kochka/pix_frame/hardware/mechanical/left_side.3mf

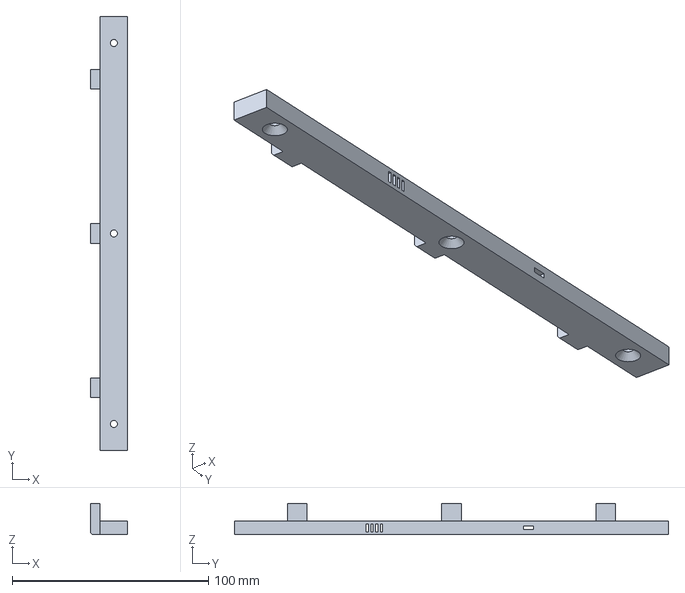
[picture p1: CAD file, 2026-11-11]
hardware/mechanical/left_side.3mf
19.0 x 221.0 x 16.0 mm
