kochka/pix_frame/hardware/mechanical/right_side.3mf

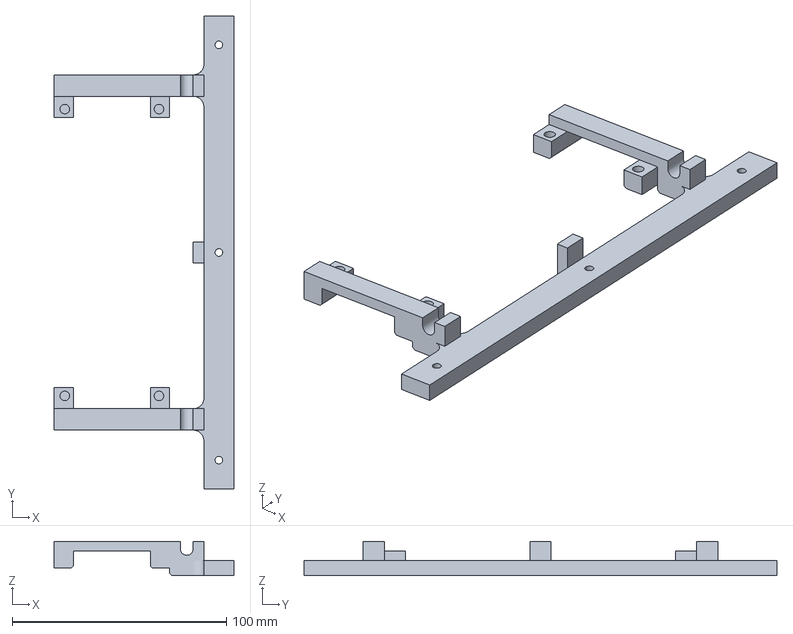
[picture p2: CAD file, 2026-11-11]
hardware/mechanical/right_side.3mf
84.0 x 221.0 x 16.0 mm
