kochka/pix_frame/hardware/mechanical/top_side.3mf

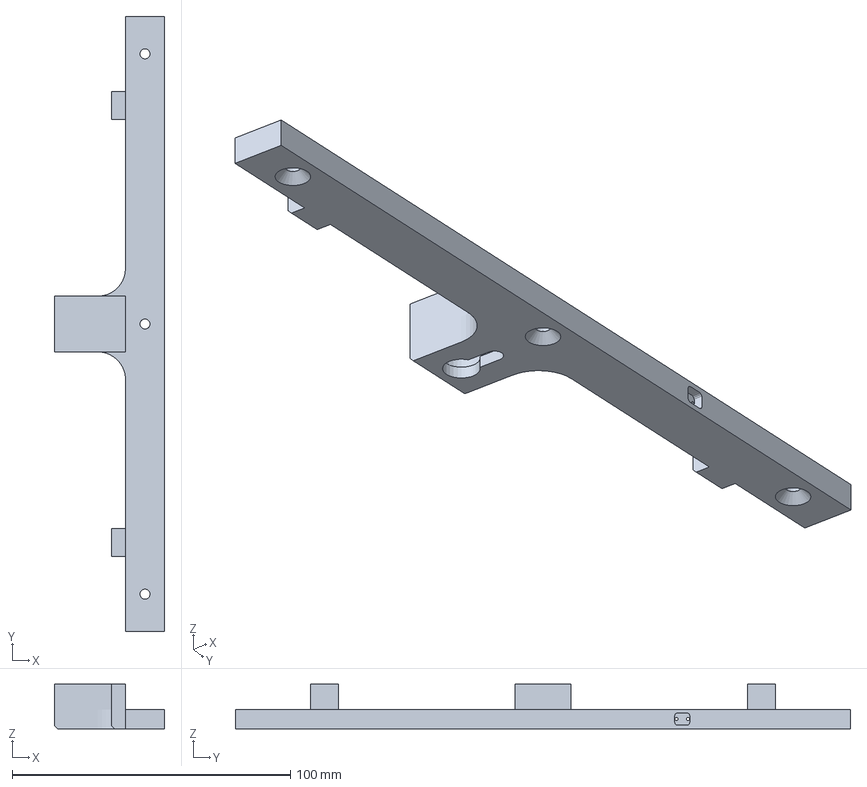
[picture p3: CAD file, 2026-11-11]
hardware/mechanical/top_side.3mf
39.5 x 221.0 x 16.0 mm
