kochka/pix_frame/hardware/mechanical/corner.3mf

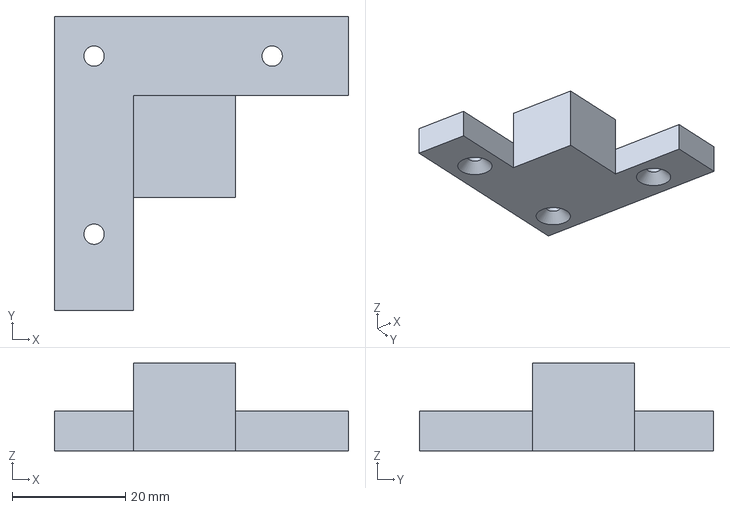
[picture p4: CAD file, 2026-11-11]
hardware/mechanical/corner.3mf
52.0 x 52.0 x 15.5 mm
