kochka/pix_frame/hardware/mechanical/bottom_side.3mf

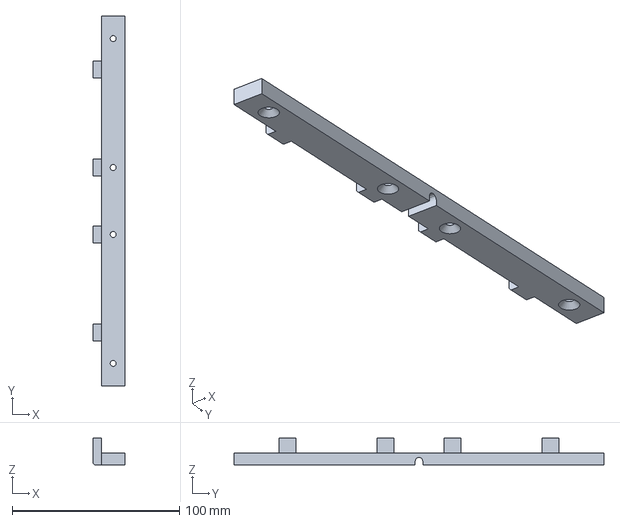
[picture p5: CAD file, 2026-11-11]
hardware/mechanical/bottom_side.3mf
19.0 x 221.0 x 16.0 mm
