kochka/pix_frame/hardware/pcb/pix-frame.kicad_pcb

## KiCad design hardware/pcb/pix-frame.kicad_pcb (2026-10-13)

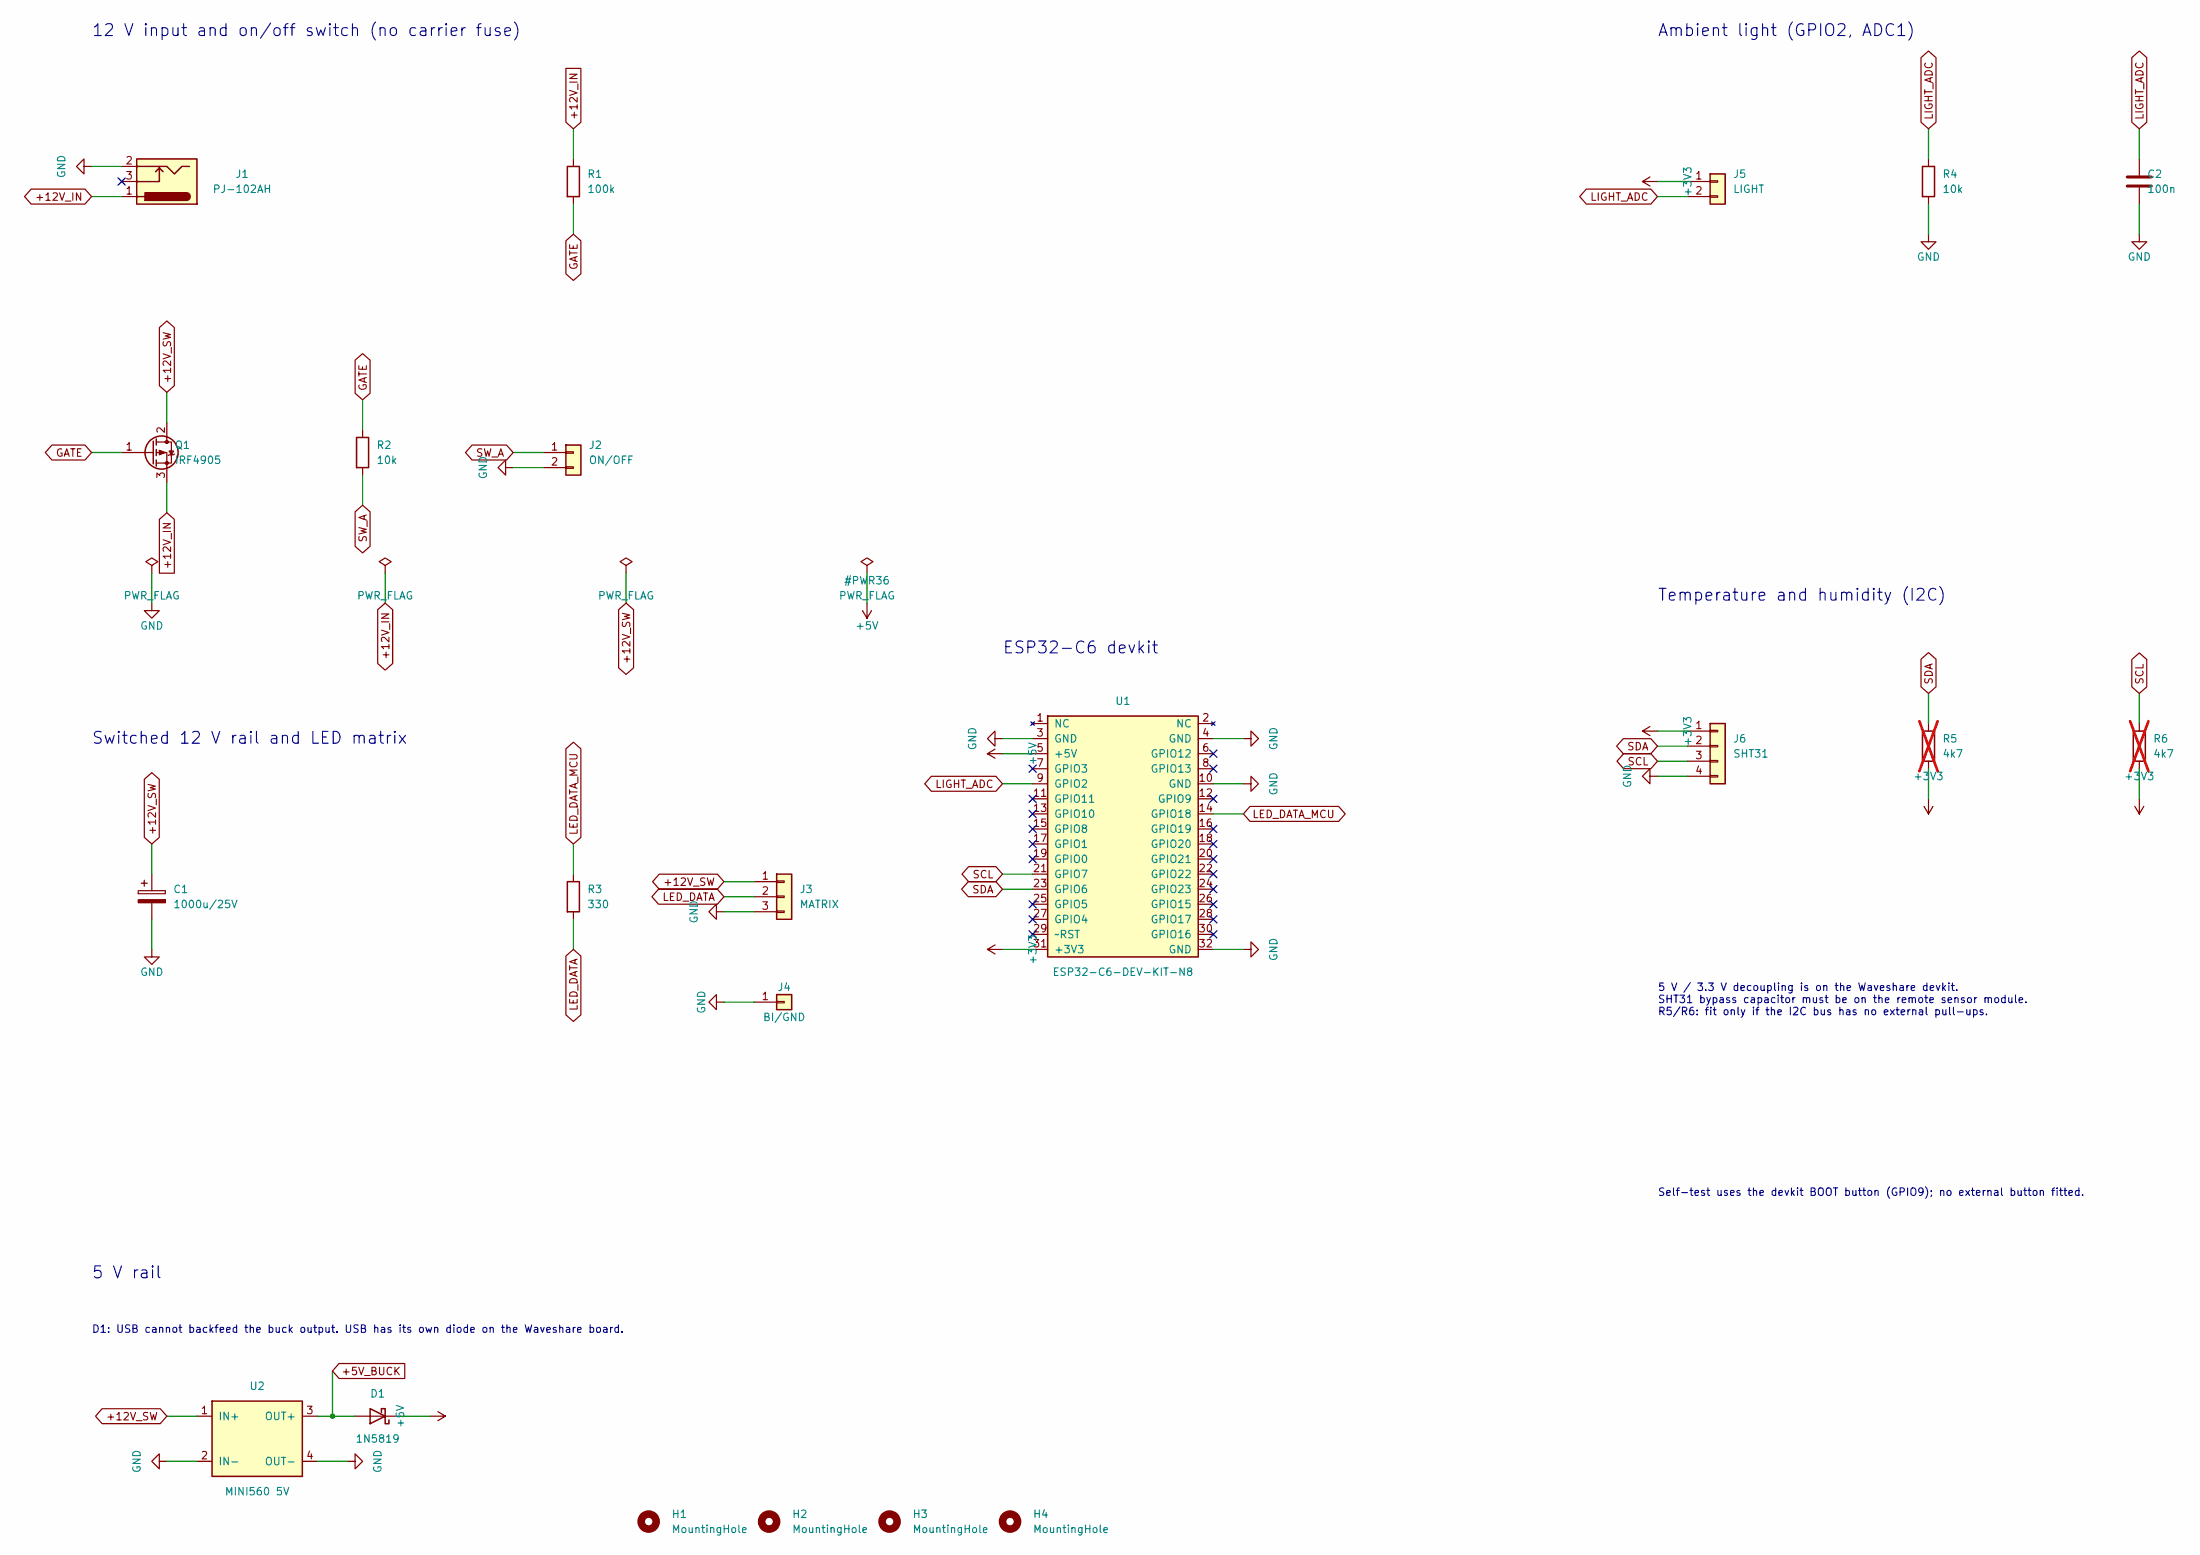
[picture p6: schematic pix-frame.kicad_sch, pix-frame carrier board]

Parts:
C1: 1000u/25V; CP_Radial_D10.5mm_L26mm_P5.00mm_Horizontal
C2: 100n; C_Disc_D5.0mm_W2.5mm_P5.00mm
D1: 1N5819; D_DO-41_SOD81_P10.16mm_Horizontal
H1, H2, H3, H4: MountingHole; MountingHole_3.2mm_M3
J1: PJ-102AH; BarrelJack_PJ102AH_Horizontal
J2: ON/OFF; WirePads_2_P4.00mm
J3: MATRIX; WirePads_Matrix_P6.00mm
J4: BI/GND; WirePad_D2.8mm_Drill1.1mm
J5: LIGHT; WirePads_2_P4.00mm
J6: SHT31; WirePads_4_P4.00mm
Q1: IRF4905; TO-220-3_Horizontal_TabUp
R1: 100k; R_Axial_DIN0207_L6.3mm_D2.5mm_P10.16mm_Horizontal
R2, R4: 10k; R_Axial_DIN0207_L6.3mm_D2.5mm_P10.16mm_Horizontal
R3: 330; R_Axial_DIN0207_L6.3mm_D2.5mm_P10.16mm_Horizontal
R5, R6: 4k7; R_Axial_DIN0207_L6.3mm_D2.5mm_P10.16mm_Horizontal; not fitted
U1: ESP32-C6-DEV-KIT-N8; ESP32-C6-DEV-KIT_Waveshare_Castellated
U2: MINI560 5V; MINI560_Buck_22.5x17mm_CornerLands

Connections:
+3V3: J5.1, J6.1, R5.2, R6.2, U1.31 (+3V3)
+5V: D1.1 (K), U1.5 (+5V)
+5V_BUCK: D1.2 (A), U2.3 (OUT+)
+12V_IN: J1.1, Q1.3 (S), R1.1
+12V_SW: C1.1, J3.1, Q1.2 (D), U2.1 (IN+)
GATE: Q1.1 (G), R1.2, R2.1
GND: C1.2, C2.2, J1.2, J2.2, J3.3, J4.1, J6.4, R4.2, U1.3 (GND), U1.4 (GND), U1.10 (GND), U1.32 (GND), U2.2 (IN-), U2.4 (OUT-)
LED_DATA: J3.2, R3.2
LED_DATA_MCU: R3.1, U1.14 (GPIO18)
LIGHT_ADC: C2.1, J5.2, R4.1, U1.9 (GPIO2)
SCL: J6.3, R6.1, U1.21 (GPIO7)
SDA: J6.2, R5.1, U1.23 (GPIO6)
SW_A: J2.1, R2.2

Notes on the sheet:
5 V rail
Switched 12 V rail and LED matrix
D1: USB cannot backfeed the buck output. USB has its own diode on the Waveshare board.
ESP32-C6 devkit
Self-test uses the devkit BOOT button (GPIO9); no external button fitted.
5 V / 3.3 V decoupling is on the Waveshare devkit. SHT31 bypass capacitor must be on the remote sensor module. R5/R6: fit only if the I2C bus has no external pull-ups.
Ambient light (GPIO2, ADC1)
Temperature and humidity (I2C)
12 V input and on/off switch (no carrier fuse)

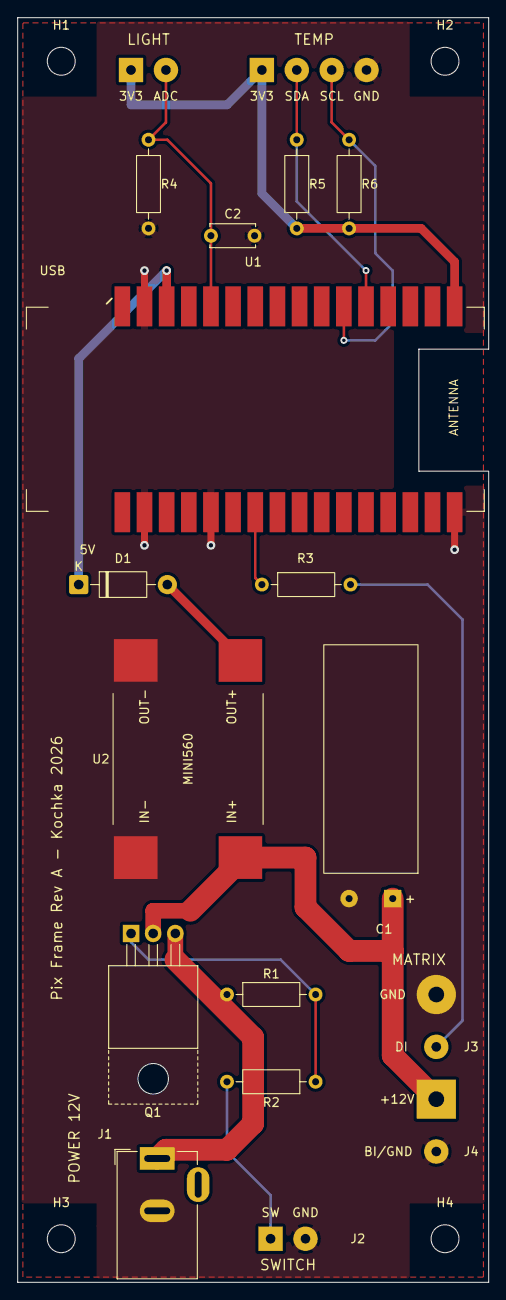
[picture p7: board pix-frame.kicad_pcb from above]

Board: 2 copper layers, 54.0 x 145.0 mm, 22 parts (0 on the bottom side), 13 nets.
