kochka/pix_frame/firmware/src/main.rs

#![no_std]
#![no_main]
#![deny(
    clippy::mem_forget,
    reason = "mem::forget is generally not safe to do with esp_hal types, especially those \
    holding buffers for the duration of a data transfer."
)]
#![deny(clippy::large_stack_frames)]

use defmt::{error, info, warn};
use embassy_executor::{SpawnError, SpawnToken, Spawner};
use embassy_net::StackResources;
use embassy_time::{Duration, Instant, Timer};
use esp_bootloader_esp_idf::partitions::{self, PARTITION_TABLE_MAX_LEN};
use esp_hal::clock::CpuClock;
use esp_hal::delay::Delay;
use esp_hal::gpio::{Input, InputConfig, Pull};
use esp_hal::i2c::master::{Config as I2cConfig, I2c};
use esp_hal::rng::Rng;
use esp_hal::rtc_cntl::Rtc;
use esp_hal::time::Rate;
use esp_hal::timer::timg::TimerGroup;
use esp_println as _;
use esp_radio::wifi::sta::{ScanMethod, StationConfig};
use esp_radio::wifi::{AuthenticationMethodConfig, ControllerConfig, Interface, WifiController};
use esp_storage::FlashStorage;
use pix_frame_firmware::catalog::{Catalog, Entry, ScanEnd};
use pix_frame_firmware::clock::Clock;
use pix_frame_firmware::config::{Config, ConfigError, Style, Wifi};
use pix_frame_firmware::display::{Canvas, MatrixLayout, Wiring};
use pix_frame_firmware::indoor;
use pix_frame_firmware::leds::SpiLeds;
use pix_frame_firmware::light;
use pix_frame_firmware::net;
use pix_frame_firmware::player::{PlayError, Player};
use pix_frame_firmware::playlist::Playlist;
use pix_frame_firmware::screens;
use pix_frame_firmware::self_test;
use pix_frame_firmware::storage::{ByteSource, FlashPartition, NvsFlash};
use smart_leds::{RGB8, SmartLedsWrite, brightness};
use static_cell::{ConstStaticCell, StaticCell};

// Physical description of the attached frame. This is the only place in the
// firmware that knows the matrix dimensions, wiring and channel order.
// See `doc/wiring.md`.
const LAYOUT: MatrixLayout = MatrixLayout {
    width: 16,
    height: 16,
    wiring: Wiring::Serpentine,
};
const LED_COUNT: usize = LAYOUT.led_count();

/// Output brightness, 0..=255, used until the ambient light sensor is
/// calibrated (`[light]` in the device configuration). Keep it modest: 256
/// WS2815 at full white draw far more than a small supply can deliver.
const BRIGHTNESS: u8 = 60;

/// Pause after a failed animation so a broken bundle does not spin the log.
const ERROR_BACKOFF: Duration = Duration::from_millis(500);

/// How long an information screen stays on before animations resume.
const INFO_SCREEN_TIME: Duration = Duration::from_millis(5_000);

/// Redraw period of an information screen, short enough for the clock
/// separator to blink in step with the seconds.
const INFO_REFRESH: Duration = Duration::from_millis(100);

/// How long the Wi-Fi result is shown after boot.
const WIFI_STATUS_TIME: Duration = Duration::from_millis(1_500);

/// Heap regions: the radio driver wants the reclaimed RAM, the rest serves
/// the NVS reader and the network stack.
const RECLAIMED_HEAP_SIZE: usize = 64 * 1024;
const HEAP_SIZE: usize = 64 * 1024;

/// Labels in `partitions.csv`.
const ANIMATIONS_PARTITION: &str = "animations";
const CONFIG_PARTITION: &str = "nvs";

/// Poll period of the self-test button while a static screen is shown.
const BUTTON_POLL: Duration = Duration::from_millis(20);

type LedDriver = SpiLeds;

static RTC: StaticCell<Rtc<'static>> = StaticCell::new();
static NET_RESOURCES: ConstStaticCell<StackResources<4>> =
    ConstStaticCell::new(StackResources::new());

#[panic_handler]
fn panic(panic_info: &core::panic::PanicInfo) -> ! {
    error!("{}", panic_info);
    loop {}
}

// This creates a default app-descriptor required by the esp-idf bootloader.
// For more information see: <https://docs.espressif.com/projects/esp-idf/en/stable/esp32/api-reference/system/app_image_format.html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>
esp_bootloader_esp_idf::esp_app_desc!();

#[allow(
    clippy::large_stack_frames,
    reason = "it's not unusual to allocate larger buffers etc. in main"
)]
#[esp_rtos::main]
async fn main(spawner: Spawner) -> ! {
    let hal_config = esp_hal::Config::default().with_cpu_clock(CpuClock::max());
    let peripherals = esp_hal::init(hal_config);
    esp_alloc::heap_allocator!(#[esp_hal::ram(reclaimed)] size: RECLAIMED_HEAP_SIZE);
    esp_alloc::heap_allocator!(size: HEAP_SIZE);

    // The scheduler must run before the radio is initialised.
    let timg0 = TimerGroup::new(peripherals.TIMG0);
    esp_rtos::start(timg0.timer0, peripherals.FROM_CPU_INTR0);

    // The WS2815 frame is wired to GPIO18; the signal is generated by SPI
    // with DMA so its timing does not depend on the CPU. See `doc/wiring.md`.
    let mut led = match SpiLeds::new(
        peripherals.SPI2,
        peripherals.DMA_CH0,
        peripherals.GPIO18,
        LED_COUNT,
    ) {
        Ok(led) => led,
        Err(err) => {
            error!("LED driver setup failed: {:?}", defmt::Debug2Format(&err));
            loop {
                Timer::after_secs(1).await;
            }
        }
    };

    let delay = Delay::new();
    let mut pixels = [RGB8::new(0, 0, 0); LED_COUNT];
    // Self-test button: GPIO9 is the BOOT button of the Espressif ESP32-C6
    // dev boards, pulled up and low when pressed. Any GPIO with a button to
    // ground works the same way. See `doc/wiring.md` section 6.
    let mut button = Button::new(Input::new(
        peripherals.GPIO9,
        InputConfig::default().with_pull(Pull::Up),
    ));

    // SHT3x temperature and humidity sensor on I2C, SDA on GPIO6 and SCL on
    // GPIO7, 100 kHz. See `doc/wiring.md` section 8.
    match I2c::new(
        peripherals.I2C0,
        I2cConfig::default().with_frequency(Rate::from_khz(100)),
    ) {
        Ok(i2c) => {
            let i2c = i2c
                .with_sda(peripherals.GPIO6)
                .with_scl(peripherals.GPIO7)
                .into_async();
            spawn(&spawner, indoor::indoor_task(i2c), "indoor");
        }
        Err(err) => error!("I2C setup failed: {:?}", err),
    }

    let mut flash = FlashStorage::new(peripherals.FLASH);
    let mut table_bytes = [0u8; PARTITION_TABLE_MAX_LEN];

    let config = match find_partition(&mut flash, &mut table_bytes, CONFIG_PARTITION) {
        Some((offset, len)) => load_config(&mut flash, offset, len),
        None => {
            warn!("partition '{}' not found, using defaults", CONFIG_PARTITION);
            Config::default()
        }
    };
    // GL5528 photoresistor divider on GPIO2, which belongs to ADC1: ADC2 is
    // unusable while the radio runs. See `doc/wiring.md` section 7.
    let sensor = light::Sensor::new(peripherals.ADC1, peripherals.GPIO2);
    spawn(&spawner, light::light_task(sensor, config.light), "light");

    let clock = Clock::new(RTC.init(Rtc::new(peripherals.RTC_TIMER)));
    let mut info_screens = screens::Rotation::default();
    let rng = Rng::new();

    if let Some(wifi) = &config.wifi {
        let timezone = config.location.as_ref().map(|l| l.timezone.clone());
        match start_network(peripherals.WIFI, wifi, &rng) {
            Ok((stack, runner, controller)) => {
                spawn(&spawner, net::net_task(runner), "net");
                spawn(&spawner, net::wifi_task(controller), "wifi");
                spawn(&spawner, net::time_task(stack, clock, timezone), "time");
                if let Some(location) = config.location.clone() {
                    spawn(
                        &spawner,
                        net::weather_task(stack, clock, location),
                        "weather",
                    );
                }
            }
            Err(err) => error!("wifi setup failed: {:?}", err),
        }
    } else {
        info!("no wifi configured, clock and network features disabled");
    }

    let (offset, len) = match find_partition(&mut flash, &mut table_bytes, ANIMATIONS_PARTITION) {
        Some(window) => window,
        None => {
            error!(
                "partition '{}' not found, running the self-test",
                ANIMATIONS_PARTITION
            );
            self_test_forever(&mut led, &mut pixels, &delay, &config.style);
        }
    };
    let mut source = match FlashPartition::new(&mut flash, offset, len) {
        Ok(source) => source,
        Err(err) => {
            error!("partition '{}' unusable: {}", ANIMATIONS_PARTITION, err);
            self_test_forever(&mut led, &mut pixels, &delay, &config.style);
        }
    };

    let (catalog, end) = Catalog::scan(&mut source);
    info!(
        "{} animations in {} bytes at {=u32:#x} ({})",
        catalog.len(),
        source.len(),
        offset,
        end
    );
    if catalog.is_empty() {
        warn!("no animations found, running the self-test");
        self_test_forever(&mut led, &mut pixels, &delay, &config.style);
    }
    if !matches!(end, ScanEnd::Terminator | ScanEnd::EndOfSource) {
        warn!("bundle indexing stopped early: {}", end);
    }

    let mut random = || rng.random();
    let mut playlist = Playlist::new(catalog.len(), &mut random);
    let mut since_info: u8 = 0;
    let min_play_time = Duration::from_millis(u64::from(config.min_play_ms));

    loop {
        if let Some(status) = net::take_announcement() {
            let mut canvas = Canvas::new(&mut pixels, &LAYOUT);
            screens::render_wifi(&mut canvas, status);
            show(&mut led, &pixels);
            if wait_or_press(WIFI_STATUS_TIME, &mut button).await {
                self_test::run(
                    &mut led,
                    &LAYOUT,
                    &mut pixels,
                    &delay,
                    net::wifi_status(),
                    &config.style,
                );
            }
        }

        if config.info_every > 0 && since_info >= config.info_every {
            since_info = 0;
            match info_screens.pick(&clock) {
                Some(screen) => {
                    info!("showing {} screen", screen);
                    let deadline = Instant::now() + INFO_SCREEN_TIME;
                    let mut pressed = false;
                    while !pressed && Instant::now() < deadline {
                        let mut canvas = Canvas::new(&mut pixels, &LAYOUT);
                        if !screens::render(screen, &mut canvas, &clock, &config.style) {
                            break;
                        }
                        show(&mut led, &pixels);
                        let remaining = deadline.saturating_duration_since(Instant::now());
                        pressed = wait_or_press(remaining.min(INFO_REFRESH), &mut button).await;
                    }
                    if pressed {
                        info!("self-test button pressed");
                        self_test::run(
                            &mut led,
                            &LAYOUT,
                            &mut pixels,
                            &delay,
                            net::wifi_status(),
                            &config.style,
                        );
                    }
                }
                None => info!("no information screen available yet"),
            }
        }

        let Some(entry) = playlist
            .next(&mut random)
            .and_then(|index| catalog.get(index))
        else {
            continue;
        };
        let header = &entry.header;
        info!(
            "playing animation at {=u32:#x}: {} frames, {} colors",
            entry.offset,
            header.frame_count(),
            header.palette_size()
        );
        match play(
            &mut led,
            &mut source,
            entry,
            &mut pixels,
            &mut button,
            min_play_time,
        )
        .await
        {
            Ok(PlayEnd::Finished) => since_info = since_info.saturating_add(1),
            Ok(PlayEnd::Interrupted) => {
                info!("self-test button pressed");
                self_test::run(
                    &mut led,
                    &LAYOUT,
                    &mut pixels,
                    &delay,
                    net::wifi_status(),
                    &config.style,
                );
            }
            Err(err) => {
                warn!("animation at {=u32:#x}: {}", entry.offset, err);
                Timer::after(ERROR_BACKOFF).await;
            }
        }
    }
}

/// Spawns a task; the token only fails when the task is already running.
fn spawn(spawner: &Spawner, token: Result<SpawnToken<impl Sized>, SpawnError>, name: &str) {
    match token {
        Ok(token) => spawner.spawn(token),
        Err(err) => error!("cannot spawn the {} task: {:?}", name, err),
    }
}

/// Configures the station and builds the network stack; the tasks driving
/// them are spawned by the caller.
#[allow(
    clippy::large_stack_frames,
    reason = "the radio configuration structs are large by design; called once from main at boot"
)]
fn start_network(
    wifi: esp_hal::peripherals::WIFI<'static>,
    credentials: &Wifi,
    rng: &Rng,
) -> Result<
    (
        embassy_net::Stack<'static>,
        embassy_net::Runner<'static, Interface>,
        WifiController<'static>,
    ),
    esp_radio::wifi::WifiError,
> {
    let ssid = credentials
        .ssid
        .as_str()
        .try_into()
        .map_err(|_| esp_radio::wifi::WifiError::InvalidArguments)?;
    let authentication = if credentials.password.is_empty() {
        AuthenticationMethodConfig::Open
    } else {
        let password = credentials
            .password
            .as_str()
            .try_into()
            .map_err(|_| esp_radio::wifi::WifiError::InvalidArguments)?;
        AuthenticationMethodConfig::Wpa2Personal(password)
    };
    // The default fast scan joins the first access point found with the
    // SSID; scanning all channels joins the strongest one, which matters on
    // a mesh network.
    let station = StationConfig::default()
        .with_ssid(ssid)
        .with_authentication(authentication)
        .with_scan_method(ScanMethod::AllChannels);
    let controller_config =
        ControllerConfig::default().with_initial_config(esp_radio::wifi::Config::Station(station));
    let controller = WifiController::new(wifi, controller_config)?;
    let interface = Interface::station();

    let seed = (u64::from(rng.random()) << 32) | u64::from(rng.random());
    let (stack, runner) = embassy_net::new(
        interface,
        embassy_net::Config::dhcpv4(Default::default()),
        NET_RESOURCES.take(),
        seed,
    );
    info!(
        "wifi station configured for '{}'",
        credentials.ssid.as_str()
    );
    Ok((stack, runner, controller))
}

/// Reads the device configuration from the NVS partition; any problem is
/// logged and leaves the defaults (no information screens, no network).
fn load_config(flash: &mut FlashStorage<'_>, offset: u32, len: u32) -> Config {
    let nvs = esp_nvs::Nvs::new(offset as usize, len as usize, NvsFlash(flash));
    let mut nvs = match nvs {
        Ok(nvs) => nvs,
        Err(err) => {
            warn!("config partition unreadable: {}", err);
            return Config::default();
        }
    };
    match Config::load(&mut nvs) {
        Ok(config) => {
            info!(
                "config: info screen every {} animations, animations play at least {} ms, \
                 temperatures in {}, wifi {}, location {}",
                config.info_every,
                config.min_play_ms,
                config.style.temperature_unit,
                config.wifi.as_ref().map_or("not set", |w| w.ssid.as_str()),
                config
                    .location
                    .as_ref()
                    .map_or("not set", |l| l.timezone.as_str())
            );
            config
        }
        Err(ConfigError::NotConfigured) => {
            info!("no configuration written yet, information screens disabled");
            Config::default()
        }
        Err(err) => {
            warn!("invalid configuration: {}", err);
            Config::default()
        }
    }
}

/// Offset and size of the partition labelled `label`, from the table in flash.
fn find_partition(
    flash: &mut FlashStorage<'_>,
    table_bytes: &mut [u8; PARTITION_TABLE_MAX_LEN],
    label: &str,
) -> Option<(u32, u32)> {
    let table = match partitions::read_partition_table(flash, table_bytes) {
        Ok(table) => table,
        Err(err) => {
            error!("cannot read the partition table: {}", err);
            return None;
        }
    };
    table
        .iter()
        .find(|entry| entry.label_as_str() == label)
        .map(|entry| (entry.offset(), entry.len()))
}

/// Active-low push button that reports each press once.
struct Button {
    input: Input<'static>,
    held: bool,
}

impl Button {
    fn new(input: Input<'static>) -> Self {
        Self { input, held: false }
    }

    /// True on the first poll after the button went down; false until it is
    /// released and pressed again.
    fn take_press(&mut self) -> bool {
        let down = self.input.is_low();
        let pressed = down && !self.held;
        self.held = down;
        pressed
    }
}

/// Why [`play`] returned.
enum PlayEnd {
    /// The minimum play time was reached at a loop boundary.
    Finished,
    /// The self-test button was pressed.
    Interrupted,
}

/// Plays one animation with deadline-based scheduling.
///
/// Frame `i + 1` is decoded while frame `i` is displayed, then sent exactly
/// when frame `i`'s duration has elapsed. Deadlines accumulate from the
/// first frame, so decoding and LED transmission time never add drift. A
/// late frame is shown as soon as it is ready; the schedule is not rebased.
/// The animation loops until `min_play_time` is reached at a loop boundary
/// and the last frame keeps its full duration before returning. The button
/// is polled at every frame boundary. Waiting yields to the other tasks.
#[allow(
    clippy::large_stack_frames,
    reason = "the player state is bounded by the display size (palette plus one packed frame)"
)]
async fn play<S: ByteSource>(
    led: &mut LedDriver,
    source: &mut S,
    entry: &Entry,
    pixels: &mut [RGB8; LED_COUNT],
    button: &mut Button,
    min_play_time: Duration,
) -> Result<PlayEnd, PlayError> {
    let mut player = Player::<LED_COUNT>::open(source, entry, &LAYOUT)?;
    let mut deadline = Instant::now();
    let mut scheduled = Duration::from_ticks(0);

    loop {
        let frame = player.next_frame(source, &LAYOUT, pixels)?;
        Timer::at(deadline).await;
        if button.take_press() {
            return Ok(PlayEnd::Interrupted);
        }
        show(led, pixels);

        let duration = Duration::from_millis(u64::from(frame.duration_ms));
        deadline += duration;
        scheduled += duration;

        if frame.is_last && scheduled >= min_play_time {
            Timer::at(deadline).await;
            return Ok(PlayEnd::Finished);
        }
    }
}

/// Waits for `duration` while polling the self-test button; true on a press.
async fn wait_or_press(duration: Duration, button: &mut Button) -> bool {
    let deadline = Instant::now() + duration;
    while Instant::now() < deadline {
        if button.take_press() {
            return true;
        }
        Timer::after(BUTTON_POLL).await;
    }
    false
}

fn show(led: &mut LedDriver, pixels: &[RGB8]) {
    if let Err(err) = led.write(brightness(
        pixels.iter().copied(),
        light::brightness().unwrap_or(BRIGHTNESS),
    )) {
        error!("LED write failed: {}", defmt::Debug2Format(&err));
    }
}

fn self_test_forever(
    led: &mut LedDriver,
    pixels: &mut [RGB8; LED_COUNT],
    delay: &Delay,
    style: &Style,
) -> ! {
    loop {
        self_test::run(led, &LAYOUT, pixels, delay, net::wifi_status(), style);
    }
}
