kochka/pix_frame/firmware/src/lib.rs

#![no_std]

extern crate alloc;

pub mod catalog;
pub mod clock;
pub mod color;
pub mod config;
pub mod display;
pub mod font;
pub mod http;
pub mod indoor;
pub mod leds;
pub mod light;
pub mod net;
pub mod player;
pub mod playlist;
pub mod screens;
pub mod self_test;
pub mod sntp;
pub mod storage;
pub mod tz;
pub mod weather;
