kochka/pix_frame/(commit log)

2026-09-18 feat(firmware): play PXA animations from a flash partition
    Add partitions.csv with an partition, index the PXA
    bundle at boot and stream frames with deadline-based scheduling.
    Animations play in a shuffled order, each for at least 3 s.
    Add mise tasks to flash the firmware and the bundle; update docs.
    [partitions.csv]
2026-09-18 feat(firmware): run the LED self-test on button press
    Poll GPIO9 (BOOT on the ESP32-C6 dev boards) at every frame boundary;
    a press runs the self-test once, then playback resumes.
2026-09-18 feat: device configuration in NVS and information screens
    Add the pixframe tool that builds the nvs partition image from
    config.toml (esp-nvs), read it in the firmware at boot, and schedule
    information screens every N animations. Add pixel fonts, a logical
    canvas, an RTC-backed clock and the clock screen, hidden until the
    time is synchronised.
2026-09-19 fix(firmware): drive the LEDs over SPI DMA and poll the button on screens
    The RMT driver refills its 48-symbol memory from the CPU, which the
    scheduler and the Wi-Fi driver now preempt, producing random pixels.
    Send the frame as a single DMA transfer on SPI2 instead (4 SPI bits per
    LED bit at 3.2 MHz). Also poll the self-test button while the clock and
    Wi-Fi status screens are shown.
    [leds.rs, lib.rs, main.rs]
2026-09-19 feat(firmware): outdoor weather screen from Open-Meteo
    Fetch the current temperature and sky condition every 15 minutes over
    plain HTTP when a location is configured, and show them as an icon
    above the temperature. The reply's UTC offset replaces the built-in
    time zone rules once available.
    [config.rs, http.rs, lib.rs, main.rs, net.rs, screens.rs, self_test.rs, weather.rs]
2026-10-03 feat(hardware): KiCad carrier board, placed but not routed
    [pix-frame.kicad_pcb, pix-frame.kicad_sch]
2026-10-03 feat(firmware): indoor temperature and humidity screen
    Read an SHT3x on I2C (GPIO6/7) every minute with an async driver. The
    screen shows a thermometer and the temperature, above a drop and the
    humidity, and is skipped without a recent reading.
    [indoor.rs, lib.rs, main.rs, screens.rs, self_test.rs]
2026-10-06 feat(firmware): ambient light brightness from a photoresistor
    Read a GL55xx divider on GPIO2 and map it onto the brightness range
    using the [light] calibration. Work around esp-hal#6412 (saturated ADC
    readings while the radio runs) until it is released.
2026-10-06 fix(firmware): join the strongest access point on mesh networks
    Scan all channels instead of joining the first AP found, and release
    the forced SAR power after each ADC conversion like ESP-IDF.
    [light.rs, main.rs]
2026-10-13 feat(hardware): add revision A ESP32-C6 carrier board
    Add KiCad schematic, routed PCB, custom footprints and 3D models.
    Integrate switched 12 V power, MINI560 converter and USB isolation.
    Provide matrix, light sensor, SHT31 and switch connections.
    Document component values, wiring, assembly and commissioning.
    Validate ERC, DRC and schematic-to-PCB connectivity.
    [pix-frame.kicad_pcb, pix-frame.kicad_sch]
2026-10-26 feat: configurable min play time, temperature unit and clock colors
2026-10-26 fix(firmware): keep repeats a third of a cycle apart across shuffles
    [playlist.rs, screens.rs]
2026-11-11 feat(hardware): add 3D-printed rear frame with PCB mount
    [bottom_side.3mf, corner.3mf, left_side.3mf, right_side.3mf, top_side.3mf]
